dsatizabal/risc-v-pony/src/gamepad.v

/*
 * Copyright (c) 2025 Pat Deegan, https://psychogenic.com
 * SPDX-License-Identifier: Apache-2.0
 * Version: 1.0.1
 *
 * Interfacing code for the Gamepad Pmod from Psycogenic Technologies,
 * designed for Tiny Tapeout.
 *
 * There are two high-level modules that most users will be interested in:
 * - gamepad_pmod_single: for a single controller;
 * - gamepad_pmod_dual: for two controllers.
 * 
 * There are also two lower-level modules that you can use if you want to
 * handle the interfacing yourself:
 * - gamepad_pmod_driver: interfaces with the Pmod and provides the raw data;
 * - gamepad_pmod_decoder: decodes the raw data into button states.
 *
 * The docs, schematics, PCB files, and firmware code for the Gamepad Pmod
 * are available at https://github.com/psychogenic/gamepad-pmod.
 */

/**
 * gamepad_pmod_driver -- Serial interface for the Gamepad Pmod.
 *
 * This module reads raw data from the Gamepad Pmod *serially*
 * and stores it in a shift register. When the latch signal is received, 
 * the data is transferred into `data_reg` for further processing.
 *
 * Functionality:
 *   - Synchronizes the `pmod_data`, `pmod_clk`, and `pmod_latch` signals 
 *     to the system clock domain.
 *   - Captures serial data on each falling edge of `pmod_clk`.
 *   - Transfers the shifted data into `data_reg` when `pmod_latch` goes low.
 *
 * Parameters:
 *   - `BIT_WIDTH`: Defines the width of `data_reg` (default: 24 bits).
 *
 * Inputs:
 *   - `rst_n`: Active-low reset.
 *   - `clk`: System clock.
 *   - `pmod_data`: Serial data input from the Pmod.
 *   - `pmod_clk`: Serial clock from the Pmod.
 *   - `pmod_latch`: Latch signal indicating the end of data transmission.
 *
 * Outputs:
 *   - `data_reg`: Captured parallel data after shifting is complete.
 */
module gamepad_pmod_driver #(
    parameter BIT_WIDTH = 24
) (
    input wire rst_n,
    input wire clk,
    input wire pmod_data,
    input wire pmod_clk,
    input wire pmod_latch,
    output reg [BIT_WIDTH-1:0] data_reg
);

  reg pmod_clk_prev;
  reg pmod_latch_prev;
  reg [BIT_WIDTH-1:0] shift_reg;

  // Sync Pmod signals to the clk domain:
  reg [1:0] pmod_data_sync;
  reg [1:0] pmod_clk_sync;
  reg [1:0] pmod_latch_sync;

  always @(posedge clk) begin
    if (~rst_n) begin
      pmod_data_sync  <= 2'b0;
      pmod_clk_sync   <= 2'b0;
      pmod_latch_sync <= 2'b0;
    end else begin
      pmod_data_sync  <= {pmod_data_sync[0], pmod_data};
      pmod_clk_sync   <= {pmod_clk_sync[0], pmod_clk};
      pmod_latch_sync <= {pmod_latch_sync[0], pmod_latch};
    end
  end

  always @(posedge clk) begin
    if (~rst_n) begin
      /* Initialize data and shift registers to all 1s so they're detected as "not present".
       * This accounts for cases where we have:
       *  - setup for 2 controllers;
       *  - only a single controller is connected; and
       *  - the driver in those cases only sends bits for a single controller.
       */
      data_reg <= {BIT_WIDTH{1'b1}};
      shift_reg <= {BIT_WIDTH{1'b1}};
      pmod_clk_prev <= 1'b0;
      pmod_latch_prev <= 1'b0;
    end else begin
      pmod_clk_prev   <= pmod_clk_sync[1];
      pmod_latch_prev <= pmod_latch_sync[1];

      // Capture data on rising edge of pmod_latch:
      if (pmod_latch_sync[1] & ~pmod_latch_prev) begin
        data_reg <= shift_reg;
      end

      // Sample data on rising edge of pmod_clk:
      if (pmod_clk_sync[1] & ~pmod_clk_prev) begin
        shift_reg <= {shift_reg[BIT_WIDTH-2:0], pmod_data_sync[1]};
      end
    end
  end

endmodule


/**
 * gamepad_pmod_decoder -- Decodes raw data from the Gamepad Pmod.
 *
 * This module takes a 12-bit parallel data register (`data_reg`) 
 * and decodes it into individual button states. It also determines
 * whether a controller is connected.
 *
 * Functionality:
 *   - If `data_reg` contains all `1's` (`0xFFF`), it indicates that no controller is connected.
 *   - Otherwise, it extracts individual button states from `data_reg`.
 *
 * Inputs:
 *   - `data_reg [11:0]`: Captured button state data from the gamepad.
 *
 * Outputs:
 *   - `b, y, select, start, up, down, left, right, a, x, l, r`: Individual button states (`1` = pressed, `0` = released).
 *   - `is_present`: Indicates whether a controller is connected (`1` = connected, `0` = not connected).
 */
module gamepad_pmod_decoder (
    input wire [11:0] data_reg,
    output wire b,
    output wire y,
    output wire select,
    output wire start,
    output wire up,
    output wire down,
    output wire left,
    output wire right,
    output wire a,
    output wire x,
    output wire l,
    output wire r,
    output wire is_present
);

  // When the controller is not connected, the data register will be all 1's
  wire reg_empty = (data_reg == 12'hfff);
  assign is_present = reg_empty ? 0 : 1'b1;
  assign {b, y, select, start, up, down, left, right, a, x, l, r} = reg_empty ? 0 : data_reg;

endmodule


/**
 * gamepad_pmod_single -- Main interface for a single Gamepad Pmod controller.
 * 
 * This module provides button states for a **single controller**, reducing 
 * resource usage (fewer flip-flops) compared to a dual-controller version.
 * 
 * Inputs:
 *   - `pmod_data`, `pmod_clk`, and `pmod_latch` are the signals from the PMOD interface.
 * 
 * Outputs:
 *   - Each button's state is provided as a single-bit wire (e.g., `start`, `up`, etc.).
 *   - `is_present` indicates whether the controller is connected (`1` = connected, `0` = not detected).
 */
module gamepad_pmod_single (
    input wire rst_n,
    input wire clk,
    input wire pmod_data,
    input wire pmod_clk,
    input wire pmod_latch,

    output wire b,
    output wire y,
    output wire select,
    output wire start,
    output wire up,
    output wire down,
    output wire left,
    output wire right,
    output wire a,
    output wire x,
    output wire l,
    output wire r,
    output wire is_present
);

  wire [11:0] gamepad_pmod_data;

  gamepad_pmod_driver #(
      .BIT_WIDTH(12)
  ) driver (
      .rst_n(rst_n),
      .clk(clk),
      .pmod_data(pmod_data),
      .pmod_clk(pmod_clk),
      .pmod_latch(pmod_latch),
      .data_reg(gamepad_pmod_data)
  );

  gamepad_pmod_decoder decoder (
      .data_reg(gamepad_pmod_data),
      .b(b),
      .y(y),
      .select(select),
      .start(start),
      .up(up),
      .down(down),
      .left(left),
      .right(right),
      .a(a),
      .x(x),
      .l(l),
      .r(r),
      .is_present(is_present)
  );

endmodule
