dsatizabal/risc-v-pony/(commit log)

2026-05-03 Added button test with ROM
2026-05-03 Fix to SPI interface
    [fake_spi.py, spi_fetcher.v, test_spi_realistic_bin_boot.py]
2026-05-03 added timer
2026-05-12 New version of SPI Fetcher + FPGA documentation
2026-05-21 Added sample basics of games
